paulix123/skambutis-esp32/enclosure/perziura-virsus.png

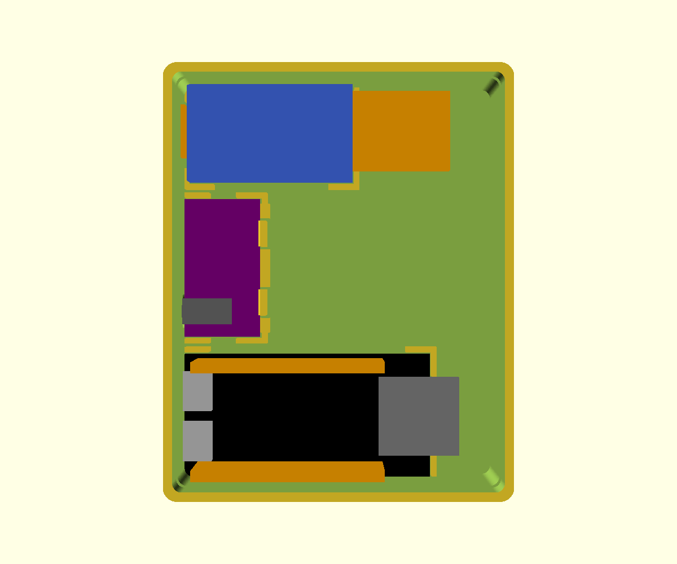
enclosure/perziura-virsus.png
