paulix123/skambutis-esp32/enclosure/perziura.png

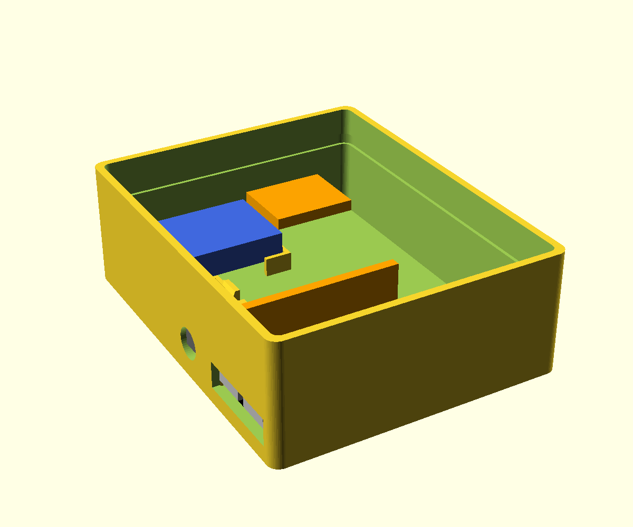
enclosure/perziura.png
