paulix123/skambutis-esp32/enclosure/box.stl

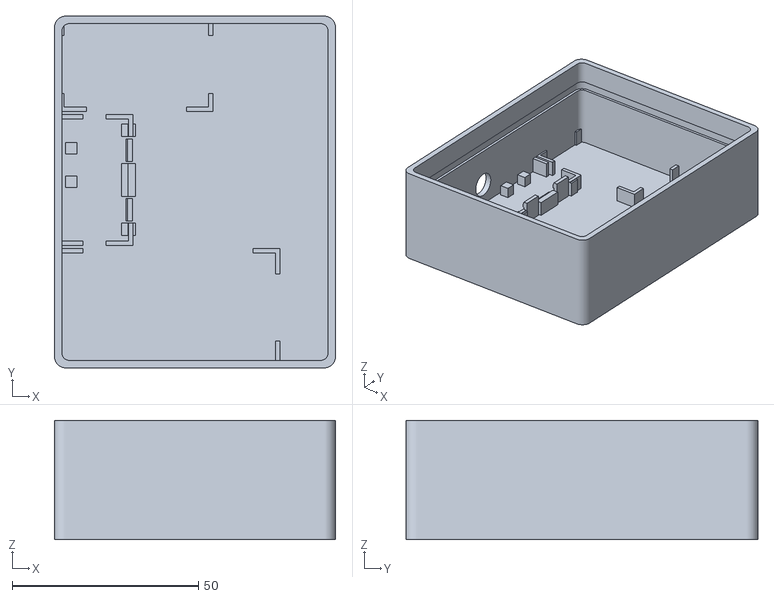
[picture p3: CAD file, 2026-10-21]
enclosure/box.stl
75.5 x 94.5 x 32.0
