paulix123/skambutis-esp32/enclosure/test.stl

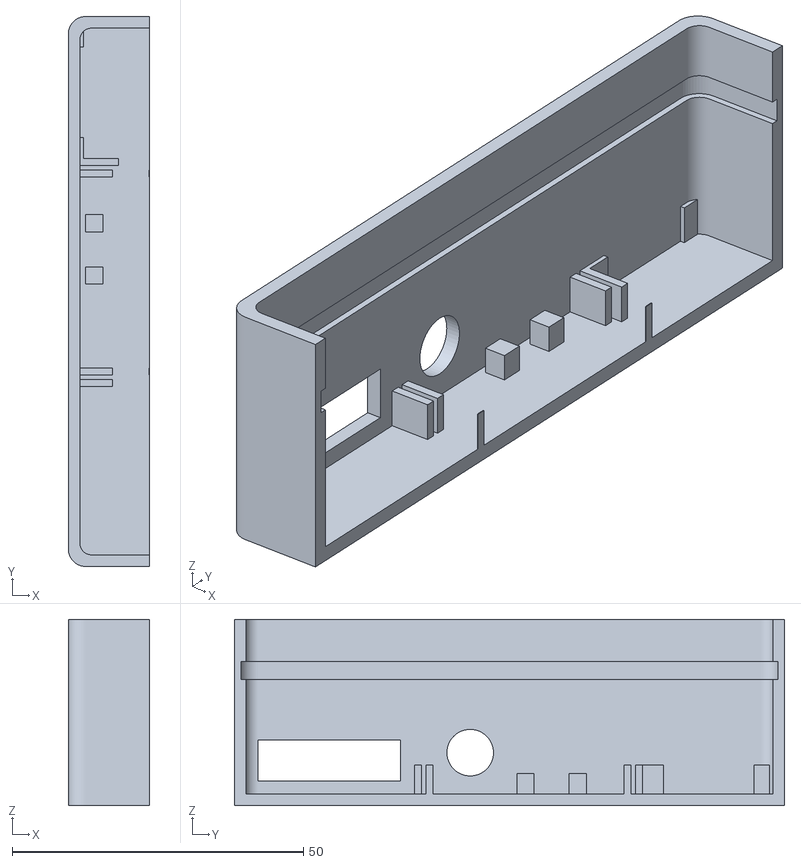
[picture p4: CAD file, 2026-10-21]
enclosure/test.stl
14.0 x 94.5 x 32.0
