paulix123/skambutis-esp32/enclosure/lid.stl

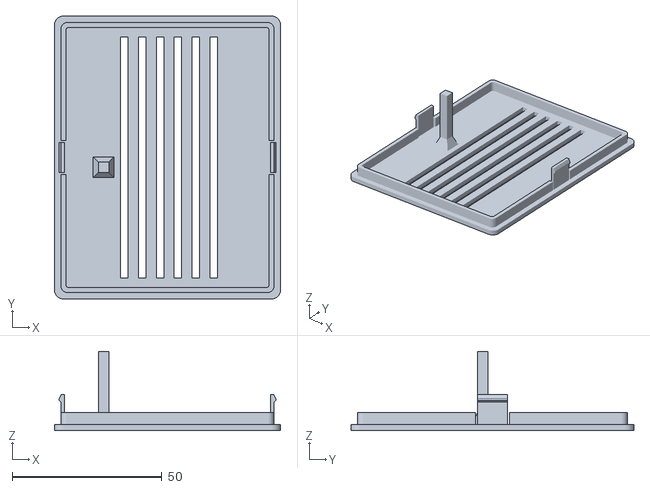
[picture p5: CAD file, 2026-10-21]
enclosure/lid.stl
75.5 x 94.5 x 26.4
