paulix123/skambutis-esp32/(commit log)

2026-10-06 feat: 0 fazė – testinis grojimas per PCM5102A
    PlatformIO projektas ESP32-S3-N16R8 (pioarduino, Arduino core 3.x),
    OTA particijos po 3 MB + 9.9 MB LittleFS, testinis sketch'as groja
    mp3/wav iš LittleFS per I2S. PLAN.md – visas dev planas.
    [partitions.csv]
2026-10-20 feat: tvarkaraštis, WiFi, laikrodis ir HTTP API
    - schedule.cpp: skambutis.py bell_times() portas + native testai
    - WiFi per WiFiManager portalą, laikas iš NTP, DS3231 (SDA 8, SCL 18)
    kaip atsarginis laikrodis; rtc.h utcToEpoch su testais
    - HTTP API (/status, /config, /files, /upload, /play, /stop, /log,
    /pin) su PIN, mDNS skambutis-esp.local + _skambutis._tcp
    - config v2: sounds[].use = bendras|pries|BALTAS|GELTONAS|RAUDONAS|off
    - DAC iš 5Vin (IN-OUT), dešinys kanalas -16 dB (TRRS / simetrinis PA)
    - tools/api_test.py – API patikrinimas iš kompiuterio
2026-10-20 feat: 3D spausdinama dėžutė
    OpenSCAD modelis ESP32-S3 + PCM5102 + DS3231 su Dupont laidais:
    USB ir 3.5 mm vienoje sienelėje, laisva zona antenai, trinties
    briaunelės dangteliui, bandomoji sienelė (test.stl). Matmenys
    pamatuoti ir pataisyti po bandomųjų spaudinių.
    [box.stl, dezute.scad, lid.stl, test.stl]
2026-10-20 feat: Windows programa skambučiui valdyti
    Tkinter langas: tvarkaraštis, garsai (įkėlimas su konvertavimu į
    MP3 48 kHz ir garsumo suvienodinimu), signalai, įrenginio būsena,
    PIN, atsarginė kopija. Įrenginys randamas per mDNS.
    GitHub Actions sukompiliuoja Skambutis.exe ir patikrina --selftest.
2026-10-20 fix: laikrodis rastas ir pataisytas be perkrovimo (0.2.1)
    Kas minutę: jei DS3231 nebuvo rastas įsijungiant – ieškom iš naujo;
    jei jo laikas buvo sustojęs, o sistemos laikas žinomas – įrašom iš
    karto, nelaukiant kito NTP sinchronizavimo.
    [main.cpp, rtc.cpp, rtc.h]
2026-10-20 feat: dangtis su dantukais, DAC spaustukai
    - dangtis užsispaudžia dviem dantukais į griovelį sienelėse;
    "◄ USB" ženklas, stulpelis prilaiko DAC iš viršaus
    - DAC įstatomas įstrižai: lizdas į skylę, galas spragteli po dviem
    spaustukais; guli ant atramų, atrama už galinio krašto
    - matmenys po bandymų: USB anga 24x7, 3.5 mm skylė +2 mm nuo USB,
    RTC kontaktų tarpas 15.5 mm
    [box.stl, dezute.scad, lid.stl, test.stl]
2026-10-21 fix: tvirtesni DAC spaustukai ir dangčio stulpelis
    Spaustukai 0.8 -> 1.3 mm ir ant viso dugno storio (0.6 mm plėvelė
    po jais lūžo), kabliukas 0.4 -> 0.3; stulpelis 3 -> 3.5 mm su
    platėjančiu pagrindu; ESP32 vieta +0.5 mm.
    [box.stl, dezute.scad, lid.stl, test.stl]
2026-10-21 fix: grįžimas prie senos versijos neveikė
    verifyRollbackLater() turi būti extern "C" – kitaip C++ vardas
    nesutampa su branduolio silpna C funkcija, lieka numatytoji, ir
    nauja versija patvirtinama iš karto įsijungus (rasta per OTA testą
    v0.2.9 -> v0.3.0). tools/version.py: FW_VERSION galima nurodyti
    aplinkos kintamuoju (OTA testams).
    [main.cpp]
2026-10-21 feat: watchdog, išliekantis žurnalas, valandinė būsena
    - watchdog 60 s: užstrigus loop() – perkrovimas (OTA ir įkėlimai jį
    maitina); patikrinta komanda H
    - žurnalas LittleFS /log.txt (+ /log.old, iš viso ~128 KB), API /log
    grąžina abu – išlieka po perkrovimo ir dingus elektrai
    - kiekvieno įsijungimo priežastis (maitinimas, watchdog, panic,
    brownout, atnaujinimas) ir kas valandą būsenos eilutė (veikimo
    laikas, heap, WiFi, RTC temperatūra) – 72 h testui
    - TZ nustatomas iš karto – po perkrovimo žurnale vietinis laikas
    [main.cpp]
2026-10-21 docs: bandomasis įrenginys ir instrukcijos ekrano nuotraukos
    tools/mock_device.py – tas pats HTTP API su pavyzdiniais duomenimis
    (programos bandymams be ESP32); app/screenshots.py + workflow
    padaro programos langų nuotraukas Windows'e.
2026-10-21 Instrukcijos nuotraukos: pirmas paleidimas be adreso ir PIN
2026-10-21 v0.4.1: atnaujinimų tikrinimas nebelūžta, signalo nenutraukia skambutis
    - Arduino core hostByName() pirmą kartą po IP gavimo kviečia dns_clear_cache()
    be TCPIP užrakto; jei tuo metu SNTP laukė DNS (strigęs tinklo DNS), lwIP assert
    -> perkrovimas kas 3 min. SNTP dabar paleidžiamas tik po saugaus
    hostByName("localhost"), atnaujinimai tikrinami tik prisijungus prie WiFi.
    - Grojant civilinės saugos signalui tvarkaraščio skambutis praleidžiamas
    (įrašoma į žurnalą), o ne nutraukia signalą.
2026-10-21 v0.4.2: PIN nebeįrašomas į žurnalą
    Žurnalas siunčiamas prižiūrėtojui laiškais, todėl PIN rodomas tik USB prievade.
2026-10-21 v0.5.0: automatiniai oro pavojaus perspėjimai iš lt72.lt
    Įrenginys kas 30 s skaito lt72.lt (PAGD) „Išsiųsti perspėjimo pranešimai“
    (WordPress REST, nes RSS Cloudflare laiko iki 4 h). Naujas GELTONA / RAUDONA /
    BALTA pranešimas mokyklos vietovei (numatyta „Vilniaus“, be Vilniaus rajono)
    pagal režimą tik įrašomas į žurnalą arba groja tą patį signalą. Seni (>15 min)
    ir jau matyti (id NVS) negrojami. Numatyta išjungta.
    Programoje – režimas, vietovė ir būsena kortelėje „Signalai ir bandymas“;
    įjungiant grojimą prašoma patvirtinimo.
